LeoMaier1/active_diff_probes/02_3D_Modelle/case3.step

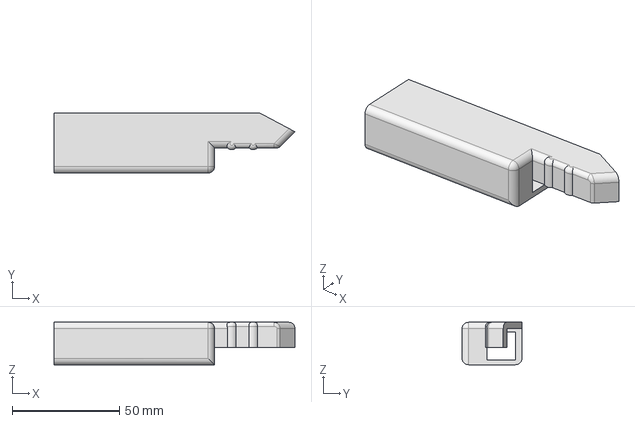
[picture p28: CAD file, 2026-10-20]
02_3D_Modelle/case3.step
112.5 x 28.0 x 19.9 mm
