LeoMaier1/active_diff_probes/02_3D_Modelle/case2.step

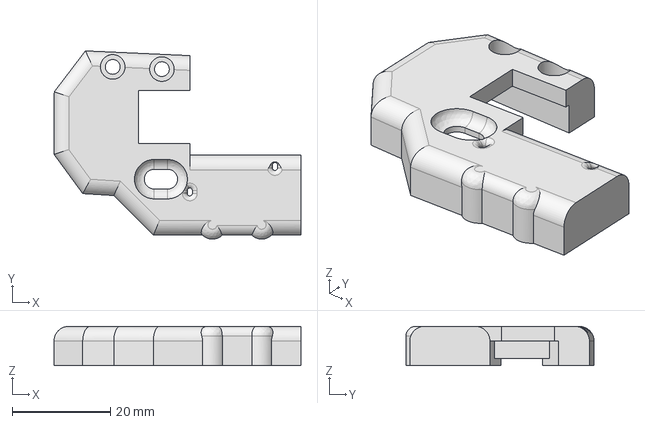
[picture p29: CAD file, 2026-10-20]
02_3D_Modelle/case2.step
50.2 x 38.3 x 8.00 mm
