LeoMaier1/active_diff_probes/02_3D_Modelle/case4.step

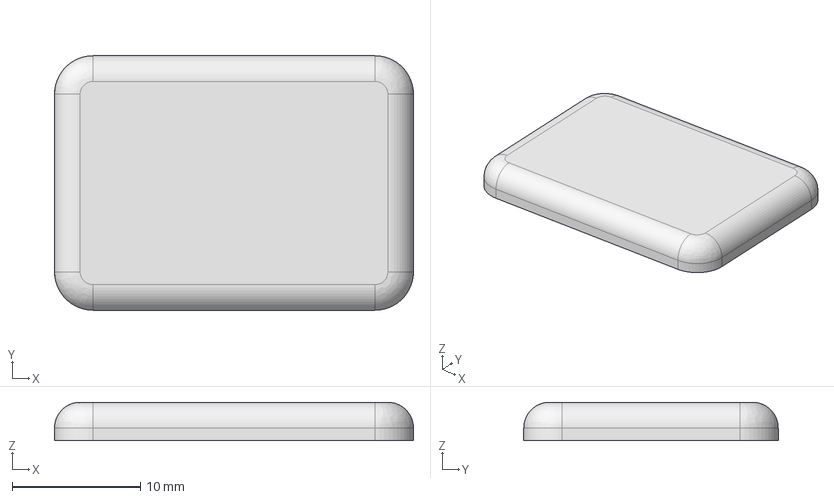
[picture p30: CAD file, 2026-10-20]
02_3D_Modelle/case4.step
28.0 x 19.9 x 3.00 mm
