LeoMaier1/active_diff_probes/02_3D_Modelle/case1.step

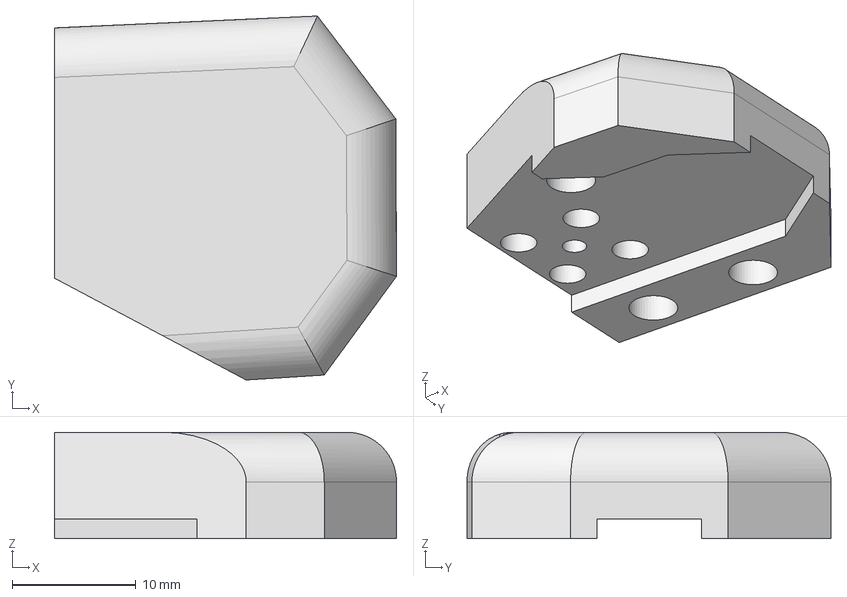
[picture p31: CAD file, 2026-10-20]
02_3D_Modelle/case1.step
27.6 x 29.4 x 8.60 mm
