LeoMaier1/active_diff_probes/(list of files, cad)

Other CAD files:
02_3D_Modelle/inventor/1.ipt
02_3D_Modelle/inventor/1_1.ipt
02_3D_Modelle/inventor/1_2.ipt
02_3D_Modelle/inventor/1_3.ipt
02_3D_Modelle/inventor/2.ipt
02_3D_Modelle/inventor/2_1.ipt
02_3D_Modelle/inventor/2_2.ipt
02_3D_Modelle/inventor/2_3.ipt
02_3D_Modelle/inventor/3.ipt
02_3D_Modelle/inventor/3_1.ipt
02_3D_Modelle/inventor/452406020024.iam
02_3D_Modelle/inventor/60711002241501_Body.ipt
02_3D_Modelle/inventor/60711002241501_Cover.ipt
02_3D_Modelle/inventor/60711002241501_Lok_Ring.ipt
02_3D_Modelle/inventor/60711002241501_Pin.ipt
02_3D_Modelle/inventor/60711002241501_Pin_2.ipt
02_3D_Modelle/inventor/60711002241501_housing.ipt
02_3D_Modelle/inventor/60711002241501_insulator.ipt
02_3D_Modelle/inventor/60711002241501_insulator_2.ipt
02_3D_Modelle/inventor/62101421021.iam
02_3D_Modelle/inventor/6210xx21021_PIN.ipt
02_3D_Modelle/inventor/621x1421021_Housing.ipt
02_3D_Modelle/inventor/8063481200.iam
02_3D_Modelle/inventor/8063483216.iam
02_3D_Modelle/inventor/8063483264.ipt
02_3D_Modelle/inventor/8063483456.iam
02_3D_Modelle/inventor/8063484080.iam
02_3D_Modelle/inventor/8063484416.ipt
02_3D_Modelle/inventor/8063484608.iam
02_3D_Modelle/inventor/8127039264.iam
02_3D_Modelle/inventor/8181075088.iam
02_3D_Modelle/inventor/Actuator.ipt
02_3D_Modelle/inventor/Analog Devices.ipt
02_3D_Modelle/inventor/BOUR-TC33X-2.iam
02_3D_Modelle/inventor/BOUR-TC33X-2_1.iam
02_3D_Modelle/inventor/BOUR-TC33X-2_2.ipt
02_3D_Modelle/inventor/Base.ipt
02_3D_Modelle/inventor/Baugruppe1.iam
02_3D_Modelle/inventor/Board.iam
02_3D_Modelle/inventor/Body_3.ipt
02_3D_Modelle/inventor/C1.iam
02_3D_Modelle/inventor/C10.iam
02_3D_Modelle/inventor/C11.iam
02_3D_Modelle/inventor/C12.iam
02_3D_Modelle/inventor/C13.iam
02_3D_Modelle/inventor/C14.iam
02_3D_Modelle/inventor/C15.iam
02_3D_Modelle/inventor/C16.iam
02_3D_Modelle/inventor/C17.iam
02_3D_Modelle/inventor/C18.iam
02_3D_Modelle/inventor/C19.iam
02_3D_Modelle/inventor/C2.iam
02_3D_Modelle/inventor/C20.iam
02_3D_Modelle/inventor/C21.iam
02_3D_Modelle/inventor/C22.iam
02_3D_Modelle/inventor/C3.iam
02_3D_Modelle/inventor/C4.iam
02_3D_Modelle/inventor/C5.iam
02_3D_Modelle/inventor/C6.iam
02_3D_Modelle/inventor/C7.iam
02_3D_Modelle/inventor/C8.iam
02_3D_Modelle/inventor/C9.iam
02_3D_Modelle/inventor/Cap_Murata_GRT155C80G225KE13J_eec.iam
02_3D_Modelle/inventor/Cap_TDK_CGA2B1X7R1A154M050BC_eec.iam
02_3D_Modelle/inventor/Cap_TDK_Corporation_CGA4J3X7R1H684M125AB_eec.iam
02_3D_Modelle/inventor/Chamfer.ipt
02_3D_Modelle/inventor/D1.iam
02_3D_Modelle/inventor/D2.iam
02_3D_Modelle/inventor/Extruded.ipt
02_3D_Modelle/inventor/Fillet1.ipt
02_3D_Modelle/inventor/Fillet1_1.ipt
02_3D_Modelle/inventor/Fillet1_2.ipt
02_3D_Modelle/inventor/Fillet1_3.ipt
02_3D_Modelle/inventor/Fillet2.ipt
02_3D_Modelle/inventor/Fillet2_1.ipt
02_3D_Modelle/inventor/Fillet2_2.ipt
02_3D_Modelle/inventor/Fillet2_3.ipt
02_3D_Modelle/inventor/FilletPin1.ipt
02_3D_Modelle/inventor/FilletPin2.ipt
02_3D_Modelle/inventor/IC_Analog_Devices_Inc_LT3045EDD#PBF_eec.iam
02_3D_Modelle/inventor/IC_Analog_Devices_LTC3600EDD#PBF_eec.iam
02_3D_Modelle/inventor/J11.iam
02_3D_Modelle/inventor/J22.iam
02_3D_Modelle/inventor/LED1.iam
02_3D_Modelle/inventor/LED2.iam
02_3D_Modelle/inventor/Murata.ipt
02_3D_Modelle/inventor/Open CASCADE STEP translator 7.5 1.1.1.ipt
02_3D_Modelle/inventor/Panasonic Logo.ipt
02_3D_Modelle/inventor/PinA.ipt
02_3D_Modelle/inventor/PinK.ipt
02_3D_Modelle/inventor/PinKIdent.ipt
02_3D_Modelle/inventor/R1.iam
02_3D_Modelle/inventor/R10.iam
02_3D_Modelle/inventor/R11.iam
02_3D_Modelle/inventor/R12.iam
02_3D_Modelle/inventor/R13.iam
02_3D_Modelle/inventor/R14.iam
02_3D_Modelle/inventor/R15.iam
02_3D_Modelle/inventor/R16.iam
02_3D_Modelle/inventor/R17.iam
02_3D_Modelle/inventor/R18.iam
02_3D_Modelle/inventor/R19.iam
02_3D_Modelle/inventor/R2.iam
02_3D_Modelle/inventor/R20.iam
02_3D_Modelle/inventor/R21.iam
02_3D_Modelle/inventor/R22.iam
02_3D_Modelle/inventor/R23.iam
02_3D_Modelle/inventor/R24.iam
02_3D_Modelle/inventor/R25.iam
02_3D_Modelle/inventor/R26.iam
02_3D_Modelle/inventor/R3.iam
02_3D_Modelle/inventor/R4.iam
02_3D_Modelle/inventor/R5.iam
02_3D_Modelle/inventor/R6.iam
02_3D_Modelle/inventor/R7.iam
02_3D_Modelle/inventor/R8.iam
02_3D_Modelle/inventor/R9.iam
02_3D_Modelle/inventor/RT0603BRD07104KL_Ceramic.ipt
02_3D_Modelle/inventor/RT0603BRD07104KL_Coating.ipt
02_3D_Modelle/inventor/RT0603BRD07104KL_Logo.ipt
02_3D_Modelle/inventor/RT0603BRD07104KL_Terminal.ipt
02_3D_Modelle/inventor/Res_Panasonic_ERA3AEB243V_eec.iam
02_3D_Modelle/inventor/Res_Susumu_RG1005P-103-D-T10_eec.iam
02_3D_Modelle/inventor/Res_Yageo_AC0402FR-0716R2L_eec.iam
02_3D_Modelle/inventor/Res_Yageo_AT0603BRD07200RL_eec.iam
02_3D_Modelle/inventor/Res_Yageo_RT0603CRE0724K3L_eec.iam
02_3D_Modelle/inventor/STP_WR-BNC_60711002241501 (rev1).iam
02_3D_Modelle/inventor/SW1.iam
02_3D_Modelle/inventor/Susumu.ipt
02_3D_Modelle/inventor/TDK Logo.ipt
02_3D_Modelle/inventor/TDK Logo_1.ipt
02_3D_Modelle/inventor/U1.iam
02_3D_Modelle/inventor/U2.iam
02_3D_Modelle/inventor/U3.iam
02_3D_Modelle/inventor/U4.iam
02_3D_Modelle/inventor/U5.iam
02_3D_Modelle/inventor/Yageo.ipt
02_3D_Modelle/inventor/body.ipt
02_3D_Modelle/inventor/body2.ipt
02_3D_Modelle/inventor/body2_1.ipt
02_3D_Modelle/inventor/body2_2.ipt
02_3D_Modelle/inventor/body2_3.ipt
02_3D_Modelle/inventor/body_1.ipt
02_3D_Modelle/inventor/body_2.ipt
02_3D_Modelle/inventor/body_4.ipt
02_3D_Modelle/inventor/body_5.ipt
02_3D_Modelle/inventor/case1.ipt
02_3D_Modelle/inventor/case2.ipt
02_3D_Modelle/inventor/case3.ipt
02_3D_Modelle/inventor/case4.ipt
02_3D_Modelle/inventor/circle.ipt
02_3D_Modelle/inventor/cover.ipt
02_3D_Modelle/inventor/diff_probe_v2.iam
02_3D_Modelle/inventor/logo.ipt
02_3D_Modelle/inventor/logo_1.ipt
02_3D_Modelle/inventor/pad.ipt
02_3D_Modelle/inventor/pins.ipt
02_3D_Modelle/inventor/side.ipt
02_3D_Modelle/inventor/side_1.ipt
02_3D_Modelle/inventor/terminal.ipt
02_3D_Modelle/inventor/top.ipt
02_3D_Modelle/inventor/top_1.ipt
