LeoMaier1/active_diff_probes/03_Hardware/Produktionsdaten/BA_Leo_Maier_DiffProbes.pdf

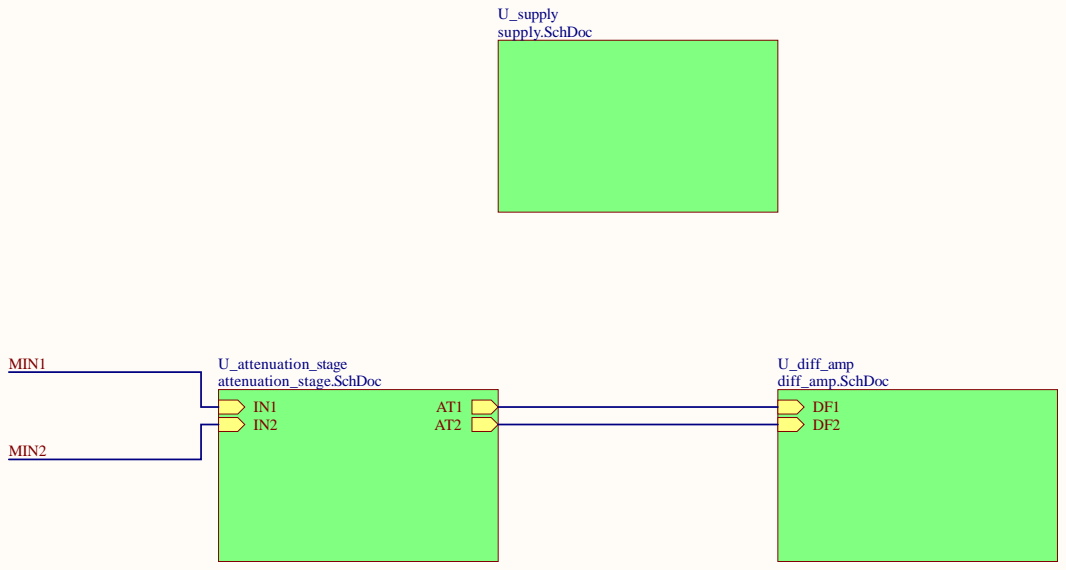
[picture p32: page 1]

Mechatronics - Electrical Engineering
MCI Management Center Innsbruck
Universitätsstraße 15

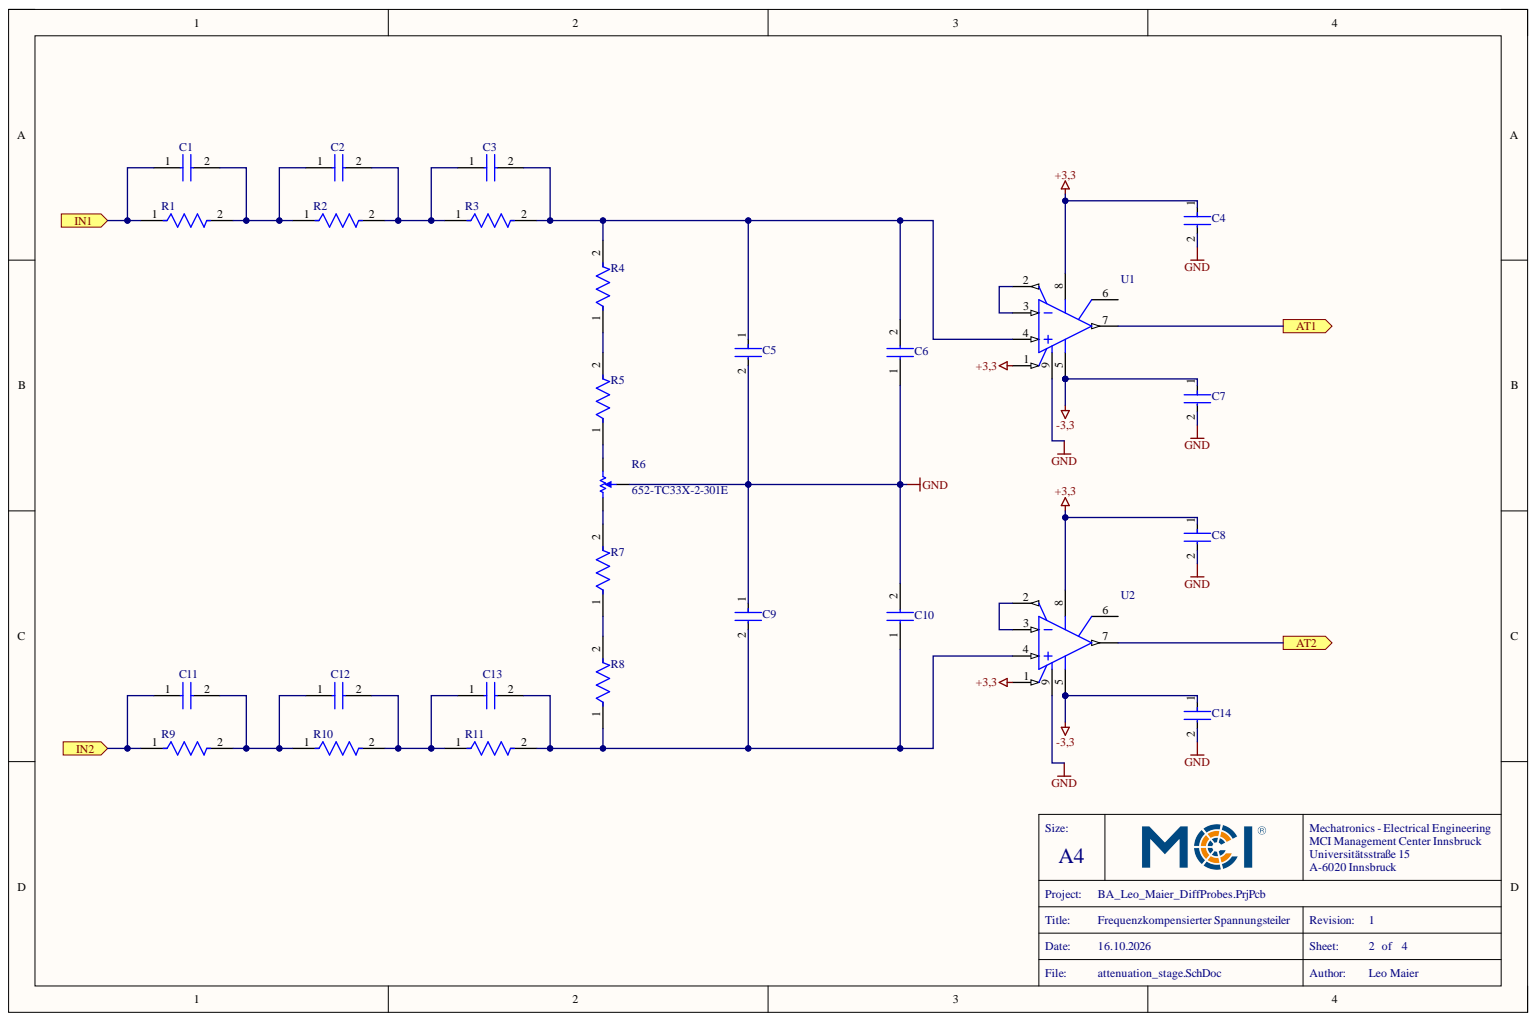
[picture p33: page 2]

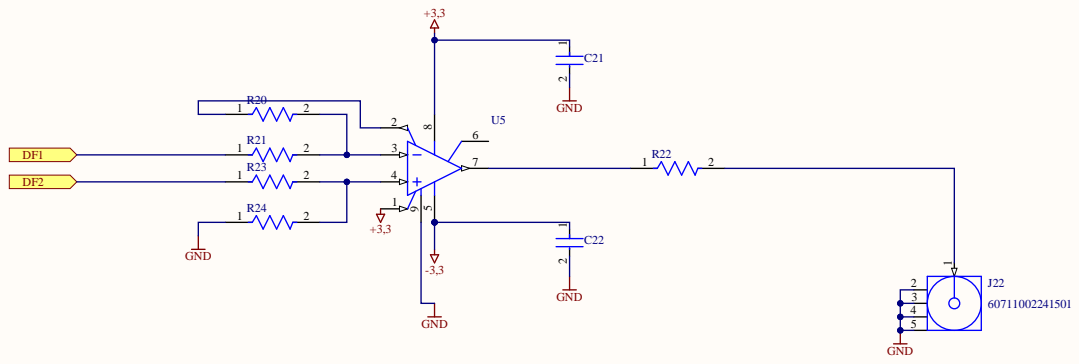
[picture p34: page 3]

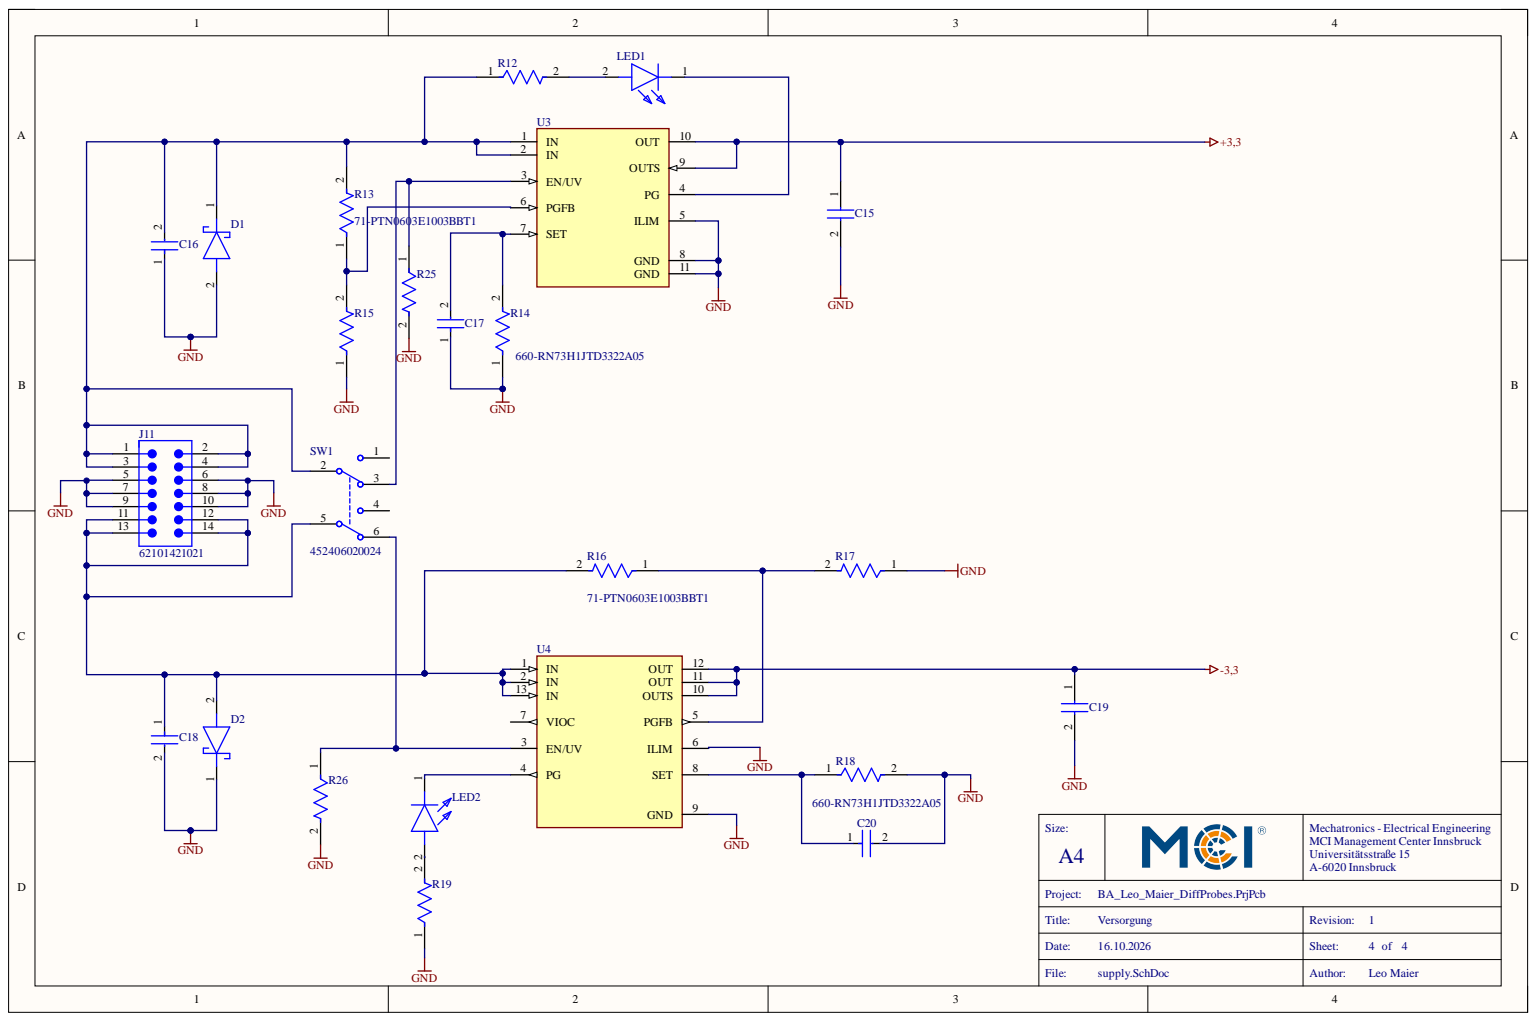
[picture p35: page 4]

Mechatronics - Electrical Engineering
MCI Management Center Innsbruck
Universitätsstraße 15
