LeoMaier1/active_diff_probes/01_Simulationen/ltspice/diffamp.asc

C1: cap; 10.5p
C2: cap; 10.5p
C3: cap; 10.5p
C4: cap; 521p
C5: cap; 10.5p
C6: cap; 10.5p
C7: cap; 10.5p
C8: cap; 521p
C9: cap; 16p
R1: res; 330K; tol=0.1
R2: res; 330K; tol=0.1
R3: res; 330K; tol=0.1
R4: res; 6.65K; tol=0.1
R5: res; 330K; tol=0.1
R6: res; 330K; tol=0.1
R7: res; 330K; tol=0.1
R8: res; 6.65K; tol=0.1
R9: res; 49.9
R10: res; 1Meg
R11: res; 400; tol=0.01
R12: res; 400; tol=0.01
R13: res; 400; tol=0.01
R14: res; 400; tol=0.01
U1: ADA4817
U2: ADA4817
U4: ADA4817
V1: voltage; SINE(0 100 250meg 0 0 0 10); AC 100
V2: voltage; SINE(0 150 250meg 0 0 0 10); AC 150
V3: voltage; 3.3
V4: voltage; 3.3
Named nets: 0, U+, U-, Uout
.tran 0 50n 0 5u
;.ac dec 100 1 250Meg
;.noise V(Uout) V1 dec 100 10 1G
