LeoMaier1/active_diff_probes/01_Simulationen/ltspice/mcdiffamp.asc

C1: cap; {mc(10.5p, 0.02)}
C2: cap; {mc(10.5p, 0.02)}
C3: cap; {mc(10.5p, 0.02)}
C4: cap; {mc(521p, 0.02)}
C5: cap; {mc(10.5p, 0.02)}
C6: cap; {mc(10.5p, 0.02)}
C7: cap; {mc(10.5p, 0.02)}
C8: cap; {mc(521p, 0.02)}
C9: cap; 16p
R1: res; {mc(330k, 0.001)}; tol=0.1
R2: res; {mc(330k, 0.001)}; tol=0.1
R3: res; {mc(330k, 0.001)}; tol=0.1
R4: res; {mc(6.65k, 0.001)}; tol=0.1
R5: res; {mc(330k, 0.001)}; tol=0.1
R6: res; {mc(330k, 0.001)}; tol=0.1
R7: res; {mc(330k, 0.001)}; tol=0.1
R8: res; {mc(6.65k, 0.001)}; tol=0.1
R9: res; {mc(400, 0.0001)}; tol=0.01
R10: res; {mc(400, 0.0001)}; tol=0.01
R11: res; {mc(400, 0.0001)}; tol=0.01
R12: res; {mc(400, 0.0001)}; tol=0.01
R13: res; {mc(49.9, 0.0001)}
R14: res; 1Meg
U1: ADA4817
U2: ADA4817
U3: ADA4817
V1: voltage; PULSE(0 150 0 2n 2n 0.5u 1u); AC 1
V2: voltage; PULSE(0 100 0 2n 2n 0.5u 1u); AC 1
V3: voltage; 3.7
V4: voltage; 3.7
Named nets: 0, U+, U-, Uout
;.tran 0 5u 0 100p
.ac dec 100 1 250Meg
;.noise V(Uout) V1 dec 100 10 1G
.step param run 1 100 1
