LeoMaier1/active_diff_probes/01_Simulationen/ltspice/supply.asc

C1: cap; 4.7µ
C2: cap; 10µ
C3: cap; 4.7µ
C4: cap; 10µ
C5: cap; 4.7µ
C6: cap; 4.7µ
D1: diode; 1N4148
D2: diode; 1N4148
R1: res; 33.2k
R2: res; 33.2k
R3: res; 100k
R4: res; 10k
R5: res; 330
R6: res; 10k
R7: res; 100
R8: res; 100
R9: res; 100k
R10: res; 330
U1: LT3045
U2: LT3094
V1: voltage; 3.2
V2: voltage; 3.7
Named nets: 0
.tran 1 startup
