LeoMaier1/active_diff_probes/(list of files, drawings)

Other design files:
03_Hardware/attenuation_stage.SchDoc
03_Hardware/BA_Leo_Maier_DiffProbes.PrjPcb
03_Hardware/diff_amp.SchDoc
03_Hardware/diff_probe.PcbDoc
03_Hardware/diff_probe.SchDoc
03_Hardware/supply.SchDoc
