LeoMaier1/active_diff_probes/03_Hardware/Produktionsdaten/Produktionsdaten_Aisler/diff_probe_v2.TXT

M48
;Layer_Color=9474304
;FILE_FORMAT=4:4
METRIC,LZ
;TYPE=PLATED
T01F00S00C0.2000
T02F00S00C0.3000
T03F00S00C1.3000
T04F00S00C2.0000
T05F00S00C3.2000
%
T01
X0036986Y0116327
Y0117427
X004005Y01206
Y01217
X0036986Y0124891
Y0125991
T02
X00352Y011882
X004135Y011825
X004545Y01091
X0048Y01049
X00535Y0109
X00551Y01086
X00571Y01066
X00632Y010495
X006415Y01075
X006679Y011081
X006928Y011068
X006991Y011017
X00715Y01044
X006437Y011398
X00597Y01138
X00522Y01142
X00414Y01237
X004055Y01246
X00352Y01235
X00342Y01212
T03
X0048514Y0122428
T04
X0045264Y0119178
X0051764
Y0125678
X0045264
T05
X004243Y011428
M30
